socialgreenhouse/SocialGreenhouse/Code/Android/ic_launcher-web.png

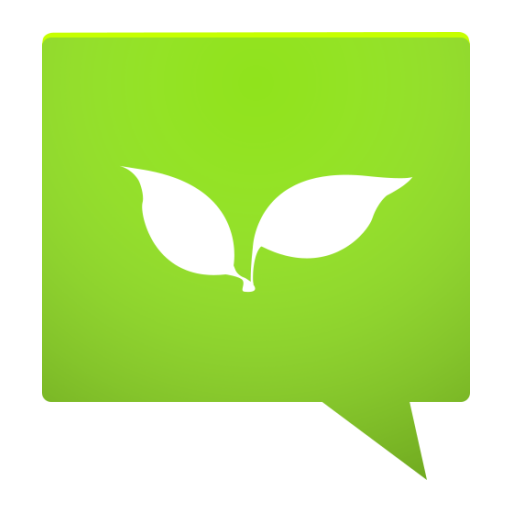
Code/Android/ic_launcher-web.png
