socialgreenhouse/SocialGreenhouse/Code/Server/Handleiding/Handleiding  installatie server.docx

# Handleiding installatie server

Requirements:

- Microsoft Windows XP of hoger / Linux
- Een Webserver met PHP (Geen IIS i.v.m. htaccess)
- Java JRE
- VertX (http://vertx.io/install.html)
- MySQL Server

Stappen:

1. Verbind met je MySQL server.
2. Maak een database met user speciaal voor je Social Greenhouse
3. Laad het database bestand naar de net gemaakte database.
4. Plaats de webservice bestanden in een gewenste locatie binnen je wwwroot/httpdocs map.
5. Pas in index.php de database gegevens aan naar de met aangemaakte database.
6. Sla het bestand op.
7. Test de verbinding door, naar http://<locatie_webservice>/index.php/modules te gaan.
8. Plaats de SocialGreenhouseServer bestanden op de gewenste locatie op de server.
9. Pas in src/com/socialgreenhouse/server/Server.java de database gegevens aan naar de net aangemaakte database.
10. Sla het bestand op.
11. Start nu de server door doormiddel van het programma run.bat(windows) of run.sh(linux).

Gefeliciteerd je hebt nu je Social Greenhouse server draaien.
